chanmeletio/Astro_Avionics/hardware/rev_a/Avionics_BOM.csv

Reference | Qty | Value | Footprint | Mfg Part# | JLCPCB Part #
BZ1 | 1 | Buzzer | Buzzer_Beeper:Buzzer_Murata_PKMCS0909E | PKMCS0909E4000-R1 | C910763
C1,C6,C7,C8,C9,C12,C13,C14,C16,C17,C18,C21,C23,C24,C29,C39,C40,C41,C42,C43,C44 | 21 | 100nF | Capacitor_SMD:C_0603_1608Metric | CL10B104KB8NNNC | C1591
C2,C5 | 2 | 6.8pF | Capacitor_SMD:C_0603_1608Metric | CL10C6R8CB8NNNC | C318672
C3,C4 | 2 | 12pF | Capacitor_SMD:C_0603_1608Metric | CL10C120JB8NNNC | C38523
C10,C19,C20,C26,C32,C35,C36,C37 | 8 | 10uF | Capacitor_SMD:C_0603_1608Metric | CL10A106MA8NRNC | C96446
C11 | 1 | 100pF | Capacitor_SMD:C_0603_1608Metric | CL10C101JB8NNNC | C14858
C15,C22 | 2 | 4.7uF | Capacitor_SMD:C_0603_1608Metric | CL10A475KO8NNNC | C19666
C25,C27,C28,C38,C46 | 5 | 10nF | Capacitor_SMD:C_0603_1608Metric | CL10B103KB8NNNC | C1589
C30,C34 | 2 | C_470uF | Capacitor_SMD:C_Elec_10x10.2 | RVT1V471M1010 | C3350
C31,C33 | 2 | 22uF | Capacitor_SMD:C_0603_1608Metric | CL10A226MP8NUNE | C86295
C45,C47 | 2 | 2.2uF | Capacitor_SMD:C_0603_1608Metric | CL10B225KP8NNNC | C100082
C48 | 1 | 1uF | Capacitor_SMD:C_0603_1608Metric | CL10B105KB8NQNC | C5199872
D1 | 1 | 1N4148W | PCM_Diode_SMD_AKL:D_SOD-123 | 1N4148W | C81598
D2,D3,D4,D5,D8 | 5 | B240A | PCM_Diode_SMD_AKL:D_SMA | B240A | C39358
D6 | 1 | SMAJ9.0A | Diode_SMD:D_SMA | SMAJ9.0A | C113955
D7 | 1 | SMAJ5.0A | Diode_SMD:D_SMA | SMAJ5.0A/TR13 | C78401
D9 | 1 | SMAJ3.3A | Diode_SMD:D_SMA | SMAJ3.3A | C2917853
J1 | 1 | PINHD_1x4_Female | Connector_PinSocket_2.54mm:PinSocket_1x04_P2.54mm_Vertical | 22850104ANG1SYA01 | C41431927
J2 | 1 | U.FL | PCM_SparkFun-Connector:U.FL | BWU.FL-IPEX1 | C5137195
J3 | 1 | 472192001 | Kicad Doc:CONN_47219-2001_MOL | 472192001 | C164170
J4,J5,J6,J7,J8 | 5 | 436500503 | CONN_SD-43650-002_05_MOL | 436500503 | C19793673
L1 | 1 | 27nH @2GHz | Inductor_SMD:L_0603_1608Metric | SDCL0603Q27NJT02B02 | C279522
L2 | 1 | 10uH | Inductor_SMD:L_0805_2012Metric | MLF2012E100JT000 | C76742
L3 | 1 | 1k Ohm @ 100mHz | PCM_Ferrite_SMD_AKL:Ferrite_0603_1608Metric | BLM18KG102SH1D | C883597
LED1 | 1 | LED_0603_Blue | PCM_LED_SMD_AKL:LED_0603_1608Metric | KT-0603B | C2288
LED2 | 1 | LED_0603_Red | PCM_LED_SMD_AKL:LED_0603_1608Metric | KT-0603R | C2286
LED3 | 1 | LED_0603_Amber | PCM_LED_SMD_AKL:LED_0603_1608Metric | KT-0603Y | C2287
LED4 | 1 | LED_0603_Green | PCM_LED_SMD_AKL:LED_0603_1608Metric | KT-0603G | C12624
Q1 | 1 | IRLML2502 | PCM_Package_TO_SOT_SMD_AKL:SOT-23 | IRLML2502TRPBF-ES | C21713837
Q2,Q3,Q4,Q5 | 4 | IRLML6344 | PCM_Package_TO_SOT_SMD_AKL:SOT-23 | IRLML6344TRPBF-HXY | C6285738
Q6 | 1 | DMP3099L | PCM_Package_TO_SOT_SMD_AKL:SOT-23 | DMP3099L | C2940610
R1,R6,R31 | 3 | 1k | Resistor_SMD:R_0603_1608Metric | RC0603JR-071KL | C14676
R2,R3,R4,R7,R10,R13,R18,R20,R22,R24,R32 | 11 | 10k | Resistor_SMD:R_0603_1608Metric | RC0603JR-0710KL | C99198
R5,R17,R19,R21,R23 | 5 | 100 | Resistor_SMD:R_0603_1608Metric | RC0603FR-07100RL | C105588
R8,R15 | 2 | 100k | Resistor_SMD:R_0603_1608Metric | RC0603FR-07100KL | C14675
R9 | 1 | 47k | Resistor_SMD:R_0603_1608Metric | AC0603FR-0747KL | C111134
R11,R12 | 2 | 5.1k | Resistor_SMD:R_0603_1608Metric | RC0603FR-075K1L | C105580
R14 | 1 | 370k | Resistor_SMD:R_1206_3216Metric | SCR1206J370K | C3018094
R16 | 1 | 12.5k | Resistor_SMD:R_0603_1608Metric | MF1/8W ±1% 12K5 OTB5 | C337058
R25 | 1 | 82k | Resistor_SMD:R_0603_1608Metric | RC0603FR-0782KL | C137678
R26,R28 | 2 | 24k | Resistor_SMD:R_0603_1608Metric | AF0603FR-0724KL | C144095
R27 | 1 | 4.7k | Resistor_SMD:R_0603_1608Metric | RC0603FR-074K7L | C99782
R29 | 1 | 2.2k | Resistor_SMD:R_0603_1608Metric | RC0603FR-072K2L | C114662
R30 | 1 | 45.3k | Resistor_SMD:R_0603_1608Metric | AC0603FR-0745K3L | C227910
RN1 | 1 | R_10k_4x1206 | PCM_Resistor_SMD_AKL:R_Array_Concave_4x0603 | YC164-FR-0710KL | C110924
SW1,SW2 | 2 |  | Button_Switch_SMD:SW_Push_1P1T_NO_E-Switch_TL3301NxxxxxG | 4-1437565-1 | C592734
U1 | 1 | STM32F405RGT7TR | Kicad Doc:LQFP64-10x10mm | STM32F405RGT7TR | C2054405
U2 | 1 | H3LIS331DLTR | Kicad Doc:QFN_31DLTR_STM | H3LIS331DLTR | C2655074
U3 | 1 | MS560702BA03-50 | Kicad Doc:SON8_MS5611_TEC | MS560702BA03-50 | C97627
U4 | 1 | BMI270 | Kicad Doc:BMI270_BOS | BMI270 | C2836813
U5 | 1 | MAX-M10S-00B | Kicad Doc:XCVR_MAX-M10S-00B | MAX-M10S-00B | C4153167
U6 | 1 | E22-400M30S | Kicad Doc:E22-400M30S | E22-400M30S | C411292
U7 | 1 | TPD4E001DBVR | DBV6 | TPD4E001DBVR | C465736
U8 | 1 | 2137160001 | Kicad Doc:2137160001_MOL | 213716-0001 | C5119949
U9 | 1 | TPS259830ONRGER | Kicad Doc:IC_TPS259830LNRGER | TPS259830ONRGER | C20611808
U10 | 1 | TPS2121RUXR | RUX0012A | TPS2121RUXR | C485916
U11 | 1 | LMR51420XDDCR | SOT23_DDC_TEX | LMR51420XDDCR | C5246146
X1 | 1 | ABLS-8.000MHZ-B2-T | Kicad Doc:ABLS-8.000MHZ-B2-T_ABR | ABLS-8.000MHZ-B2-T | C596837
X2 | 1 | ABS07-32.768KHZ-T | Kicad Doc:CAP_ABS07-32.768KHZ-T_ABR | ABS07-32.768KHZ-T | C130253
