chanmeletio/Astro_Avionics/(list of files, cad)

Other CAD files:
hardware/rev_a/Avionics.step
