chanmeletio/Astro_Avionics/hardware/rev_a/New_Flight_Controller.kicad_pcb

## KiCad design hardware/rev_a/New_Flight_Controller.kicad_pcb (2026-10-27)

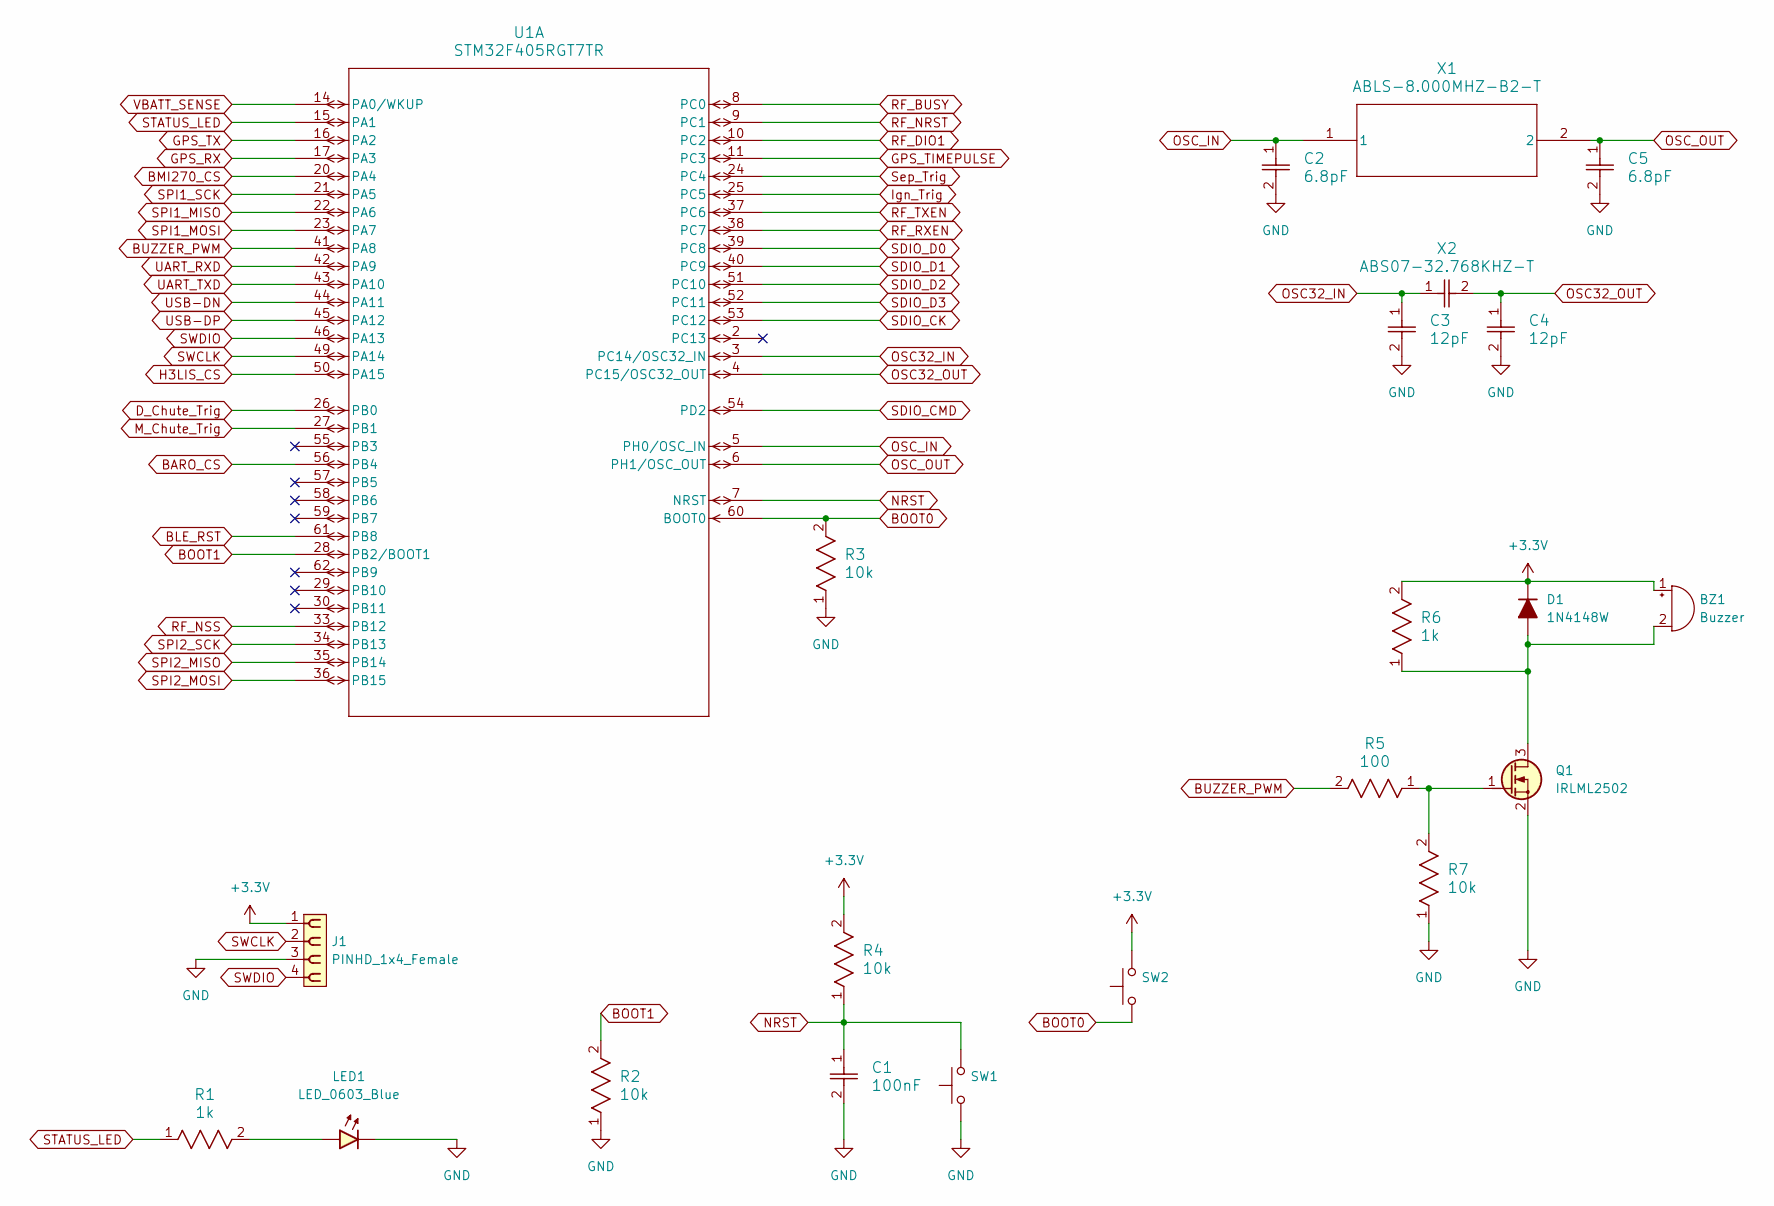
[picture p1: schematic mcu_1.kicad_sch, IREC 2027 SRAD Avionics]

Parts:
BZ1: Buzzer; Buzzer_Murata_PKMCS0909E; Mfg Part# PKMCS0909E4000-R1; JLCPCB Part # C910763
C1: 100nF; C_0603_1608Metric; Mfg Part# CL10B104KB8NNNC; JLCPCB Part # C1591
C2, C5: 6.8pF; C_0603_1608Metric; Mfg Part# CL10C6R8CB8NNNC; JLCPCB Part # C318672
C3, C4: 12pF; C_0603_1608Metric; Mfg Part# CL10C120JB8NNNC; JLCPCB Part # C38523
D1: 1N4148W; D_SOD-123; Mfg Part# 1N4148W; JLCPCB Part # C81598
J1: PINHD_1x4_Female; PinSocket_1x04_P2.54mm_Vertical; Mfg Part# 22850104ANG1SYA01; JLCPCB Part # C41431927
LED1: LED_0603_Blue; LED_0603_1608Metric; Mfg Part# KT-0603B; JLCPCB Part # C2288
Q1: IRLML2502; SOT-23; Mfg Part# IRLML2502TRPBF-ES; JLCPCB Part # C21713837
R1, R6: 1k; R_0603_1608Metric; Mfg Part# RC0603JR-071KL; JLCPCB Part # C14676
R2, R3, R4, R7: 10k; R_0603_1608Metric; Mfg Part# RC0603JR-0710KL; JLCPCB Part # C99198
R5: 100; R_0603_1608Metric; Mfg Part# RC0603FR-07100RL; JLCPCB Part # C105588
SW1, SW2: SW_Push_1P1T_NO_E-Switch_TL3301NxxxxxG; Mfg Part# 4-1437565-1; JLCPCB Part # C592734
U1: STM32F405RGT7TR; LQFP64-10x10mm; Mfg Part# STM32F405RGT7TR; JLCPCB Part # C2054405
X1: ABLS-8.000MHZ-B2-T; ABLS-8.000MHZ-B2-T_ABR; Mfg Part# ABLS-8.000MHZ-B2-T; JLCPCB Part # C596837
X2: ABS07-32.768KHZ-T; CAP_ABS07-32.768KHZ-T_ABR; Mfg Part# ABS07-32.768KHZ-T; JLCPCB Part # C130253

Connections:
+3.3V: BZ1.1 (+), D1.1 (K), J1.1, R4.2, R6.2, SW2.2; also elsewhere on the board
BARO_CS: U1.56 (PB4); also elsewhere on the board
BLE_RST: U1.61 (PB8); also elsewhere on the board
BMI270_CS: U1.20 (PA4); also elsewhere on the board
BOOT0: R3.2, SW2.1, U1.60 (BOOT0)
BOOT1: R2.2, U1.28 (PB2/BOOT1)
BUZZER_PWM: R5.2, U1.41 (PA8)
D_Chute_Trig: U1.26 (PB0); also elsewhere on the board
GND: C1.2, C2.2, C3.2, C4.2, C5.2, J1.3, LED1.1 (K), Q1.2 (S), R2.1, R3.1, R7.1, SW1.1; also elsewhere on the board
GPS_RX: U1.17 (PA3); also elsewhere on the board
GPS_TIMEPULSE: U1.11 (PC3); also elsewhere on the board
GPS_TX: U1.16 (PA2); also elsewhere on the board
H3LIS_CS: U1.50 (PA15); also elsewhere on the board
Ign_Trig: U1.25 (PC5); also elsewhere on the board
M_Chute_Trig: U1.27 (PB1); also elsewhere on the board
NRST: C1.1, R4.1, SW1.2, U1.7 (NRST)
unnamed: BZ1.2 (-), D1.2 (A), Q1.3 (D), R6.1
unnamed: LED1.2 (A), R1.2
unnamed: Q1.1 (G), R5.1, R7.2
OSC32_IN: C3.1, U1.3 (PC14/OSC32_IN), X2.1
OSC32_OUT: C4.1, U1.4 (PC15/OSC32_OUT), X2.2
OSC_IN: C2.1, U1.5 (PH0/OSC_IN), X1.1
OSC_OUT: C5.1, U1.6 (PH1/OSC_OUT), X1.2
RF_BUSY: U1.8 (PC0); also elsewhere on the board
RF_DIO1: U1.10 (PC2); also elsewhere on the board
RF_NRST: U1.9 (PC1); also elsewhere on the board
RF_NSS: U1.33 (PB12); also elsewhere on the board
RF_RXEN: U1.38 (PC7); also elsewhere on the board
RF_TXEN: U1.37 (PC6); also elsewhere on the board
SDIO_CK: U1.53 (PC12); also elsewhere on the board
SDIO_CMD: U1.54 (PD2); also elsewhere on the board
SDIO_D0: U1.39 (PC8); also elsewhere on the board
SDIO_D1: U1.40 (PC9); also elsewhere on the board
SDIO_D2: U1.51 (PC10); also elsewhere on the board
SDIO_D3: U1.52 (PC11); also elsewhere on the board
SPI1_MISO: U1.22 (PA6); also elsewhere on the board
SPI1_MOSI: U1.23 (PA7); also elsewhere on the board
SPI1_SCK: U1.21 (PA5); also elsewhere on the board
SPI2_MISO: U1.35 (PB14); also elsewhere on the board
SPI2_MOSI: U1.36 (PB15); also elsewhere on the board
SPI2_SCK: U1.34 (PB13); also elsewhere on the board
STATUS_LED: R1.1, U1.15 (PA1)
SWCLK: J1.2, U1.49 (PA14)
SWDIO: J1.4, U1.46 (PA13)
Sep_Trig: U1.24 (PC4); also elsewhere on the board
UART_RXD: U1.42 (PA9); also elsewhere on the board
UART_TXD: U1.43 (PA10); also elsewhere on the board
USB-DN: U1.44 (PA11); also elsewhere on the board
USB-DP: U1.45 (PA12); also elsewhere on the board
VBATT_SENSE: U1.14 (PA0/WKUP); also elsewhere on the board

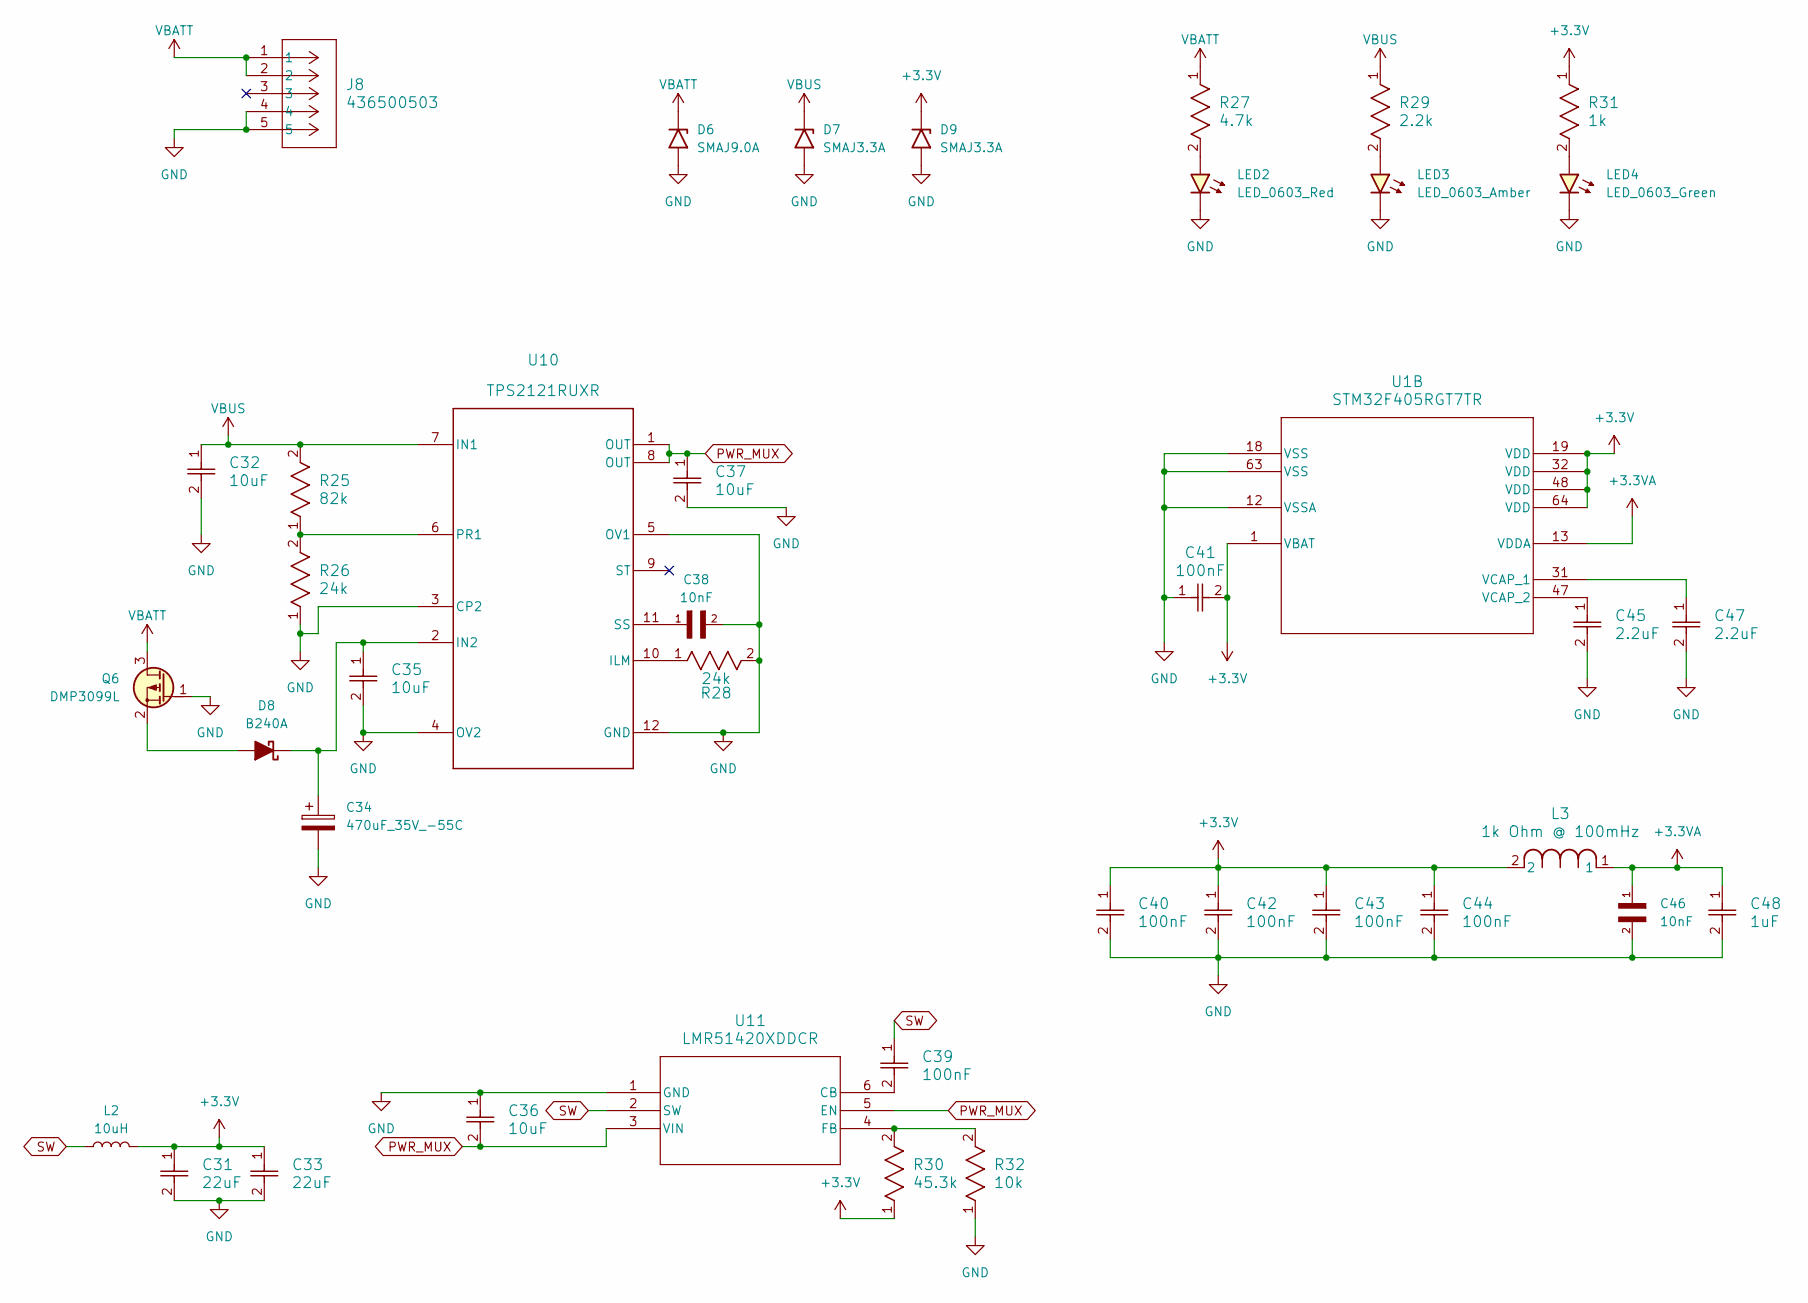
[picture p2: schematic power.kicad_sch, IREC 2027 SRAD Avionics]

Parts:
C31, C33: 22uF; C_0603_1608Metric; Mfg Part# CL10A226MP8NUNE; JLCPCB Part # C86295
C32, C35, C36, C37: 10uF; C_0603_1608Metric; Mfg Part# CL10A106MA8NRNC; JLCPCB Part # C96446
C34: 470uF_35V_-55C; C_Elec_10x10.2; Mfg Part# 189RV0073; JLCPCB Part # C18203153
C38, C46: 10nF; C_0603_1608Metric; Mfg Part# CL10B103KB8NNNC; JLCPCB Part # C1589
C39, C40, C41, C42, C43, C44: 100nF; C_0603_1608Metric; Mfg Part# CL10B104KB8NNNC; JLCPCB Part # C1591
C45, C47: 2.2uF; C_0603_1608Metric; Mfg Part# CL10B225KP8NNNC; JLCPCB Part # C100082
C48: 1uF; C_0603_1608Metric; Mfg Part# CL10B105KB8NQNC; JLCPCB Part # C5199872
D6: SMAJ9.0A; D_SMA; Mfg Part# SMAJ9.0A; JLCPCB Part # C113955
D7: SMAJ3.3A; D_SMA; Mfg Part# SMAJ3.3A; JLCPCB Part # C18199544
D8: B240A; D_SMA; Mfg Part# B240A; JLCPCB Part # C39358
D9: SMAJ3.3A; D_SMA; Mfg Part# SMAJ3.3A; JLCPCB Part # C2917853
J8: 436500503; CONN_SD-43650-002_05_MOL; Mfg Part# 436500503; JLCPCB Part # C19793673
L2: 10uH; L_0805_2012Metric; Mfg Part# MLF2012E100JT000; JLCPCB Part # C76742
L3: 1k Ohm @ 100mHz; Ferrite_0603_1608Metric; Mfg Part# BLM18KG102SH1D; JLCPCB Part # C883597
LED2: LED_0603_Red; LED_0603_1608Metric; Mfg Part# KT-0603R; JLCPCB Part # C2286
LED3: LED_0603_Amber; LED_0603_1608Metric; Mfg Part# KT-0603Y; JLCPCB Part # C2287
LED4: LED_0603_Green; LED_0603_1608Metric; Mfg Part# KT-0603G; JLCPCB Part # C12624
Q6: DMP3099L; SOT-23; Mfg Part# DMP3099L; JLCPCB Part # C2940610
R25: 82k; R_0603_1608Metric; Mfg Part# RC0603FR-0782KL; JLCPCB Part # C137678
R26, R28: 24k; R_0603_1608Metric; Mfg Part# 0603WAF2402T5E; JLCPCB Part # C23352
R27: 4.7k; R_0603_1608Metric; Mfg Part# RC0603FR-074K7L; JLCPCB Part # C99782
R29: 2.2k; R_0603_1608Metric; Mfg Part# RC0603FR-072K2L; JLCPCB Part # C114662
R30: 45.3k; R_0603_1608Metric; Mfg Part# AC0603FR-0745K3L; JLCPCB Part # C227910
R31: 1k; R_0603_1608Metric; Mfg Part# RC0603JR-071KL; JLCPCB Part # C14676
R32: 10k; R_0603_1608Metric; Mfg Part# RC0603JR-0710KL; JLCPCB Part # C99198
U1: STM32F405RGT7TR; LQFP64-10x10mm; Mfg Part# STM32F405RGT7TR; JLCPCB Part # C2054405
U10: TPS2121RUXR; RUX0012A; Mfg Part# TPS2121RUXR; JLCPCB Part # C485916
U11: LMR51420XDDCR; SOT23_DDC_TEX; Mfg Part# LMR51420XDDCR; JLCPCB Part # C5246146

Connections:
+3.3V: C31.1, C33.1, C40.1, C41.2, C42.1, C43.1, C44.1, D9.1 (A1), L2.2, L3.2, R30.1, R31.1, U1.1 (VBAT), U1.19 (VDD), U1.32 (VDD), U1.48 (VDD), U1.64 (VDD); also elsewhere on the board
+3.3VA: C46.1, C48.1, L3.1, U1.13 (VDDA)
GND: C31.2, C32.2, C33.2, C34.2, C35.2, C36.1, C37.2, C38.2, C40.2, C41.1, C42.2, C43.2, C44.2, C45.2, C46.2, C47.2, C48.2, D6.2 (A2), D7.2 (A2), D9.2 (A2), J8.4, J8.5, LED2.1 (K), LED3.1 (K), LED4.1 (K), Q6.1 (G), R26.1, R28.2, R32.1, U1.12 (VSSA), U1.18 (VSS), U1.63 (VSS), U10.3 (CP2), U10.4 (OV2), U10.5 (OV1), U10.12 (GND), U11.1 (GND); also elsewhere on the board
unnamed: D8.2 (A), Q6.2 (S)
unnamed: C34.1, C35.1, D8.1 (K), U10.2 (IN2)
unnamed: LED2.2 (A), R27.2
unnamed: LED3.2 (A), R29.2
unnamed: LED4.2 (A), R31.2
unnamed: C47.1, U1.31 (VCAP_1)
unnamed: C45.1, U1.47 (VCAP_2)
unnamed: R28.1, U10.10 (ILM)
unnamed: R25.1, R26.2, U10.6 (PR1)
unnamed: C38.1, U10.11 (SS)
unnamed: C39.2, U11.6 (CB)
unnamed: R30.2, R32.2, U11.4 (FB)
PWR_MUX: C36.2, C37.1, U10.1 (OUT), U10.8 (OUT), U11.3 (VIN), U11.5 (EN)
SW: C39.1, L2.1, U11.2 (SW)
VBATT: D6.1 (A1), J8.1, J8.2, Q6.3 (D), R27.1; also elsewhere on the board
VBUS: C32.1, D7.1 (A1), R25.2, R29.1, U10.7 (IN1); also elsewhere on the board

Schematic: microsd.kicad_sch, IREC 2027 SRAD Avionics

Parts:
C21, C23: 100nF; C_0603_1608Metric; Mfg Part# CL10B104KB8NNNC; JLCPCB Part # C1591
C22: 4.7uF; C_0603_1608Metric; Mfg Part# CL10A475KO8NNNC; JLCPCB Part # C19666
J3: 472192001; CONN_47219-2001_MOL; Mfg Part# 472192001; JLCPCB Part # C164170
R11, R12: 5.1k; R_0603_1608Metric; Mfg Part# RC0603FR-075K1L; JLCPCB Part # C105580
R13: 10k; R_0603_1608Metric; Mfg Part# RC0603JR-0710KL; JLCPCB Part # C99198
RN1: R_10k_4x1206; R_Array_Concave_4x0603; Mfg Part# YC164-FR-0710KL; JLCPCB Part # C110924
U7: TPD4E001DBVR; SOT-23-6; Mfg Part# TPD4E001DBVR; JLCPCB Part # C465736
U8: 2137160001; 2137160001_MOL; Mfg Part# 213716-0001; JLCPCB Part # C5119949

Connections:
+3.3V: C22.1, C23.1, J3.4, R13.1, RN1.1 (R1.1), RN1.2 (R2.1), RN1.3 (R3.1), RN1.4 (R4.1); also elsewhere on the board
CC1: R11.1, U7.3 (IO2), U8.A5 (CC1)
CC2: R12.2, U7.4 (IO3), U8.B5 (CC2)
GND: C21.2, C22.2, C23.2, J3.6, R11.2, R12.1, U7.2 (GND), U8.A1 (GND), U8.A12 (GND), U8.B1 (GND), U8.B12 (GND); also elsewhere on the board
SDIO_CK: J3.5; also elsewhere on the board
SDIO_CMD: J3.3, RN1.6 (R3.2); also elsewhere on the board
SDIO_D0: J3.7, R13.2; also elsewhere on the board
SDIO_D1: J3.8, RN1.5 (R4.2); also elsewhere on the board
SDIO_D2: J3.1, RN1.8 (R1.2); also elsewhere on the board
SDIO_D3: J3.2, RN1.7 (R2.2); also elsewhere on the board
USB-DN: U7.6 (IO4), U8.A7 (DN1), U8.B7 (DN2); also elsewhere on the board
USB-DP: U7.1 (IO1), U8.A6 (DP1), U8.B6 (DP2); also elsewhere on the board
VBUS: C21.1, U7.5 (VCC), U8.A4 (VBUS), U8.A9 (VBUS), U8.B4 (VBUS), U8.B9 (VBUS); also elsewhere on the board

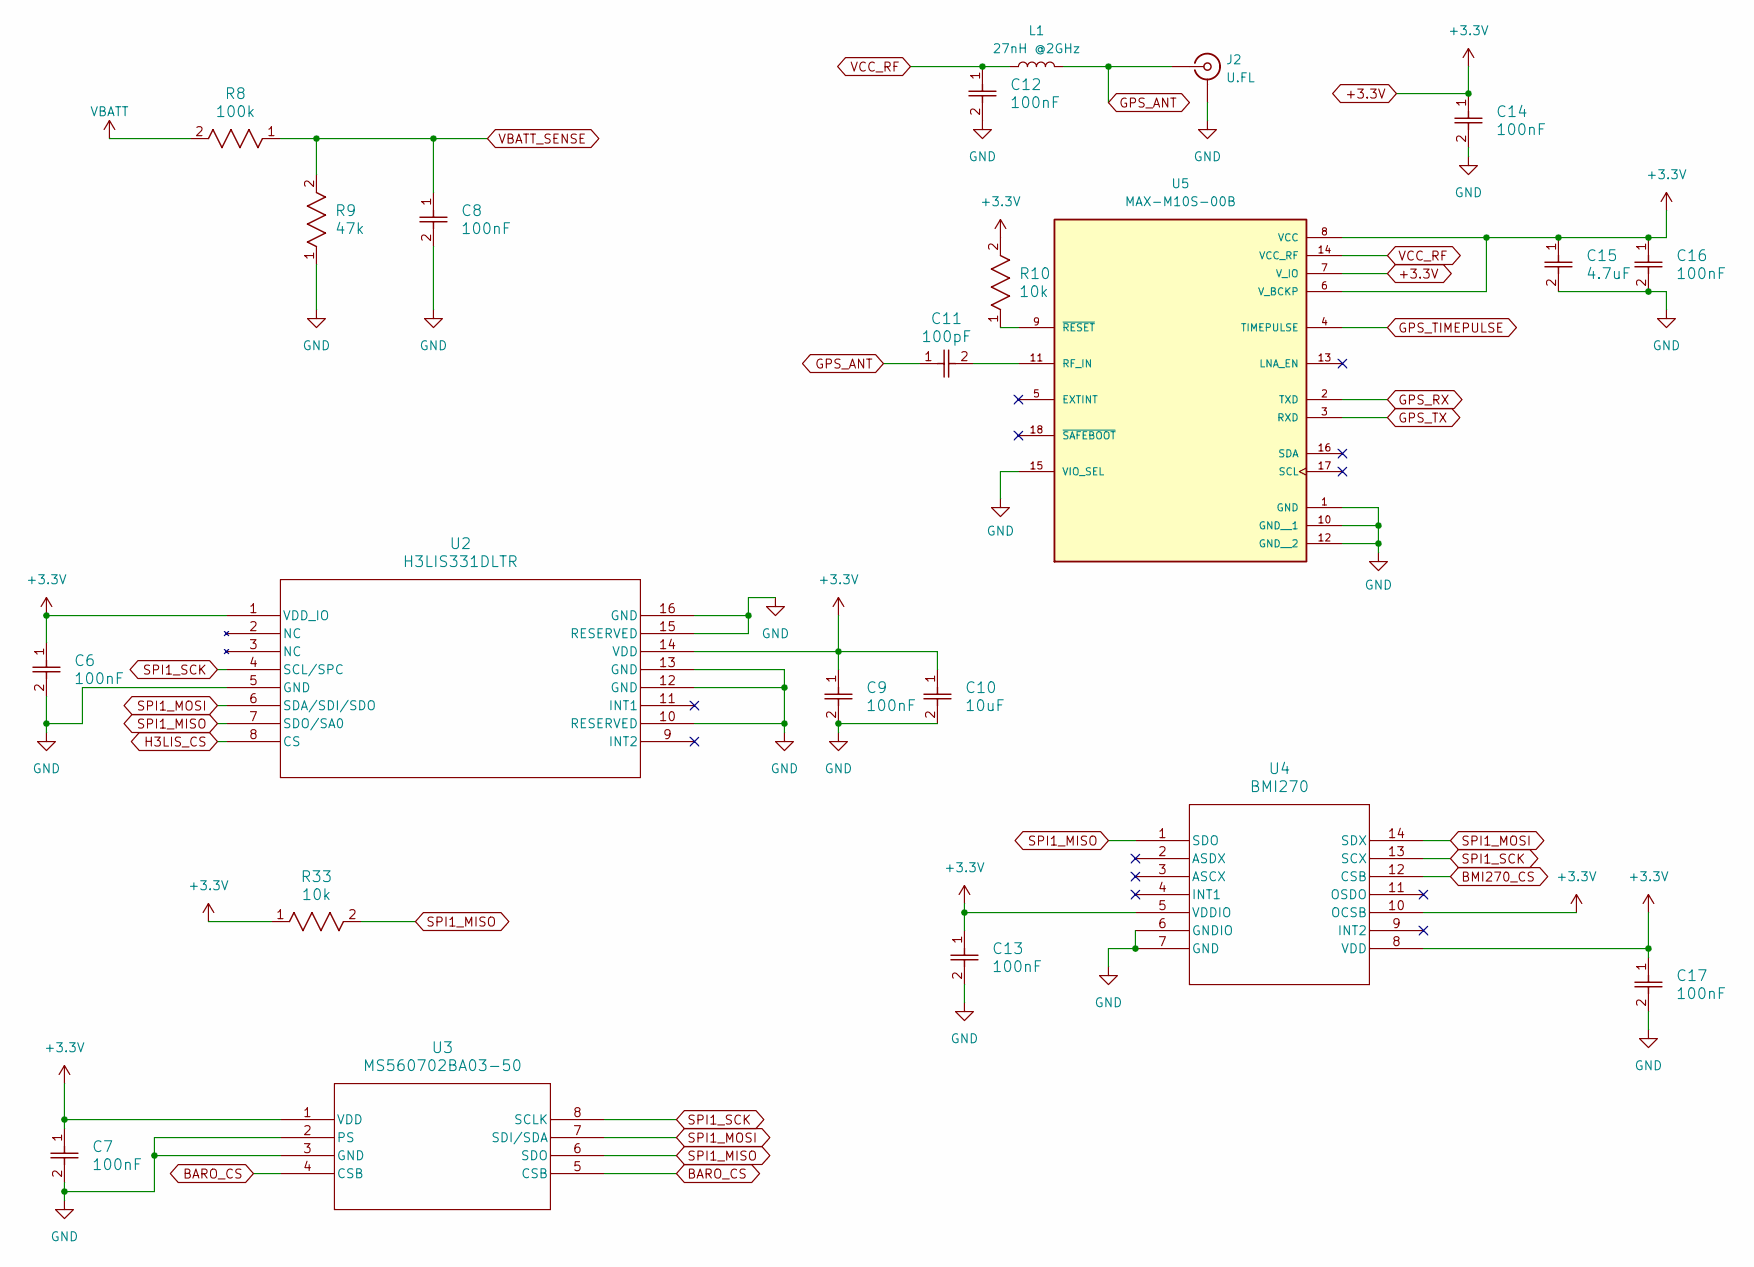
[picture p3: schematic sensors.kicad_sch, IREC 2027 SRAD Avionics]

Parts:
C6, C7, C8, C9, C12, C13, C14, C16, C17: 100nF; C_0603_1608Metric; Mfg Part# CL10B104KB8NNNC; JLCPCB Part # C1591
C10: 10uF; C_0603_1608Metric; Mfg Part# CL10A106MA8NRNC; JLCPCB Part # C96446
C11: 100pF; C_0603_1608Metric; Mfg Part# CL10C101JB8NNNC; JLCPCB Part # C14858
C15: 4.7uF; C_0603_1608Metric; Mfg Part# CL10A475KO8NNNC; JLCPCB Part # C19666
J2: U.FL; Mfg Part# BWU.FL-IPEX1; JLCPCB Part # C5137195
L1: 27nH @2GHz; L_0603_1608Metric; Mfg Part# SDCL0603Q27NJT02B02; JLCPCB Part # C279522
R8: 100k; R_0603_1608Metric; Mfg Part# RC0603FR-07100KL; JLCPCB Part # C14675
R9: 47k; R_0603_1608Metric; Mfg Part# AC0603FR-0747KL; JLCPCB Part # C111134
R10, R33: 10k; R_0603_1608Metric; Mfg Part# RC0603JR-0710KL; JLCPCB Part # C99198
U2: H3LIS331DLTR; QFN_31DLTR_STM; Mfg Part# H3LIS331DLTR; JLCPCB Part # C2655074
U3: MS560702BA03-50; SON8_MS5611_TEC; Mfg Part# MS560702BA03-50; JLCPCB Part # C97627
U4: BMI270; BMI270_BOS; Mfg Part# BMI270; JLCPCB Part # C2836813
U5: MAX-M10S-00B; XCVR_MAX-M10S-00B; PARTREV C1; JLCPCB Part # C4153167

Connections:
+3.3V: C6.1, C7.1, C9.1, C10.1, C13.1, C14.1, C15.1, C16.1, C17.1, R10.2, R33.1, U2.1 (VDD_IO), U2.14 (VDD), U3.1 (VDD), U4.5 (VDDIO), U4.8 (VDD), U4.10 (OCSB), U5.6 (V_BCKP), U5.7 (V_IO), U5.8 (VCC); also elsewhere on the board
BARO_CS: U3.4 (CSB), U3.5 (CSB); also elsewhere on the board
BMI270_CS: U4.12 (CSB); also elsewhere on the board
GND: C6.2, C7.2, C8.2, C9.2, C10.2, C12.2, C13.2, C14.2, C15.2, C16.2, C17.2, J2.2 (Ext), R9.1, U2.5 (GND), U2.10 (RESERVED), U2.12 (GND), U2.13 (GND), U2.15 (RESERVED), U2.16 (GND), U3.2 (PS), U3.3 (GND), U4.6 (GNDIO), U4.7 (GND), U5.1 (GND), U5.10 (GND__1), U5.12 (GND__2), U5.15 (VIO_SEL); also elsewhere on the board
GPS_ANT: C11.1, J2.1 (In), L1.2
GPS_RX: U5.2 (TXD); also elsewhere on the board
GPS_TIMEPULSE: U5.4 (TIMEPULSE); also elsewhere on the board
GPS_TX: U5.3 (RXD); also elsewhere on the board
H3LIS_CS: U2.8 (CS); also elsewhere on the board
unnamed: C11.2, U5.11 (RF_IN)
unnamed: R10.1, U5.9 (~RESET)
SPI1_MISO: R33.2, U2.7 (SDO/SA0), U3.6 (SDO), U4.1 (SDO); also elsewhere on the board
SPI1_MOSI: U2.6 (SDA/SDI/SDO), U3.7 (SDI/SDA), U4.14 (SDX); also elsewhere on the board
SPI1_SCK: U2.4 (SCL/SPC), U3.8 (SCLK), U4.13 (SCX); also elsewhere on the board
VBATT: R8.2; also elsewhere on the board
VBATT_SENSE: C8.1, R8.1, R9.2; also elsewhere on the board
VCC_RF: C12.1, L1.1, U5.14 (VCC_RF)

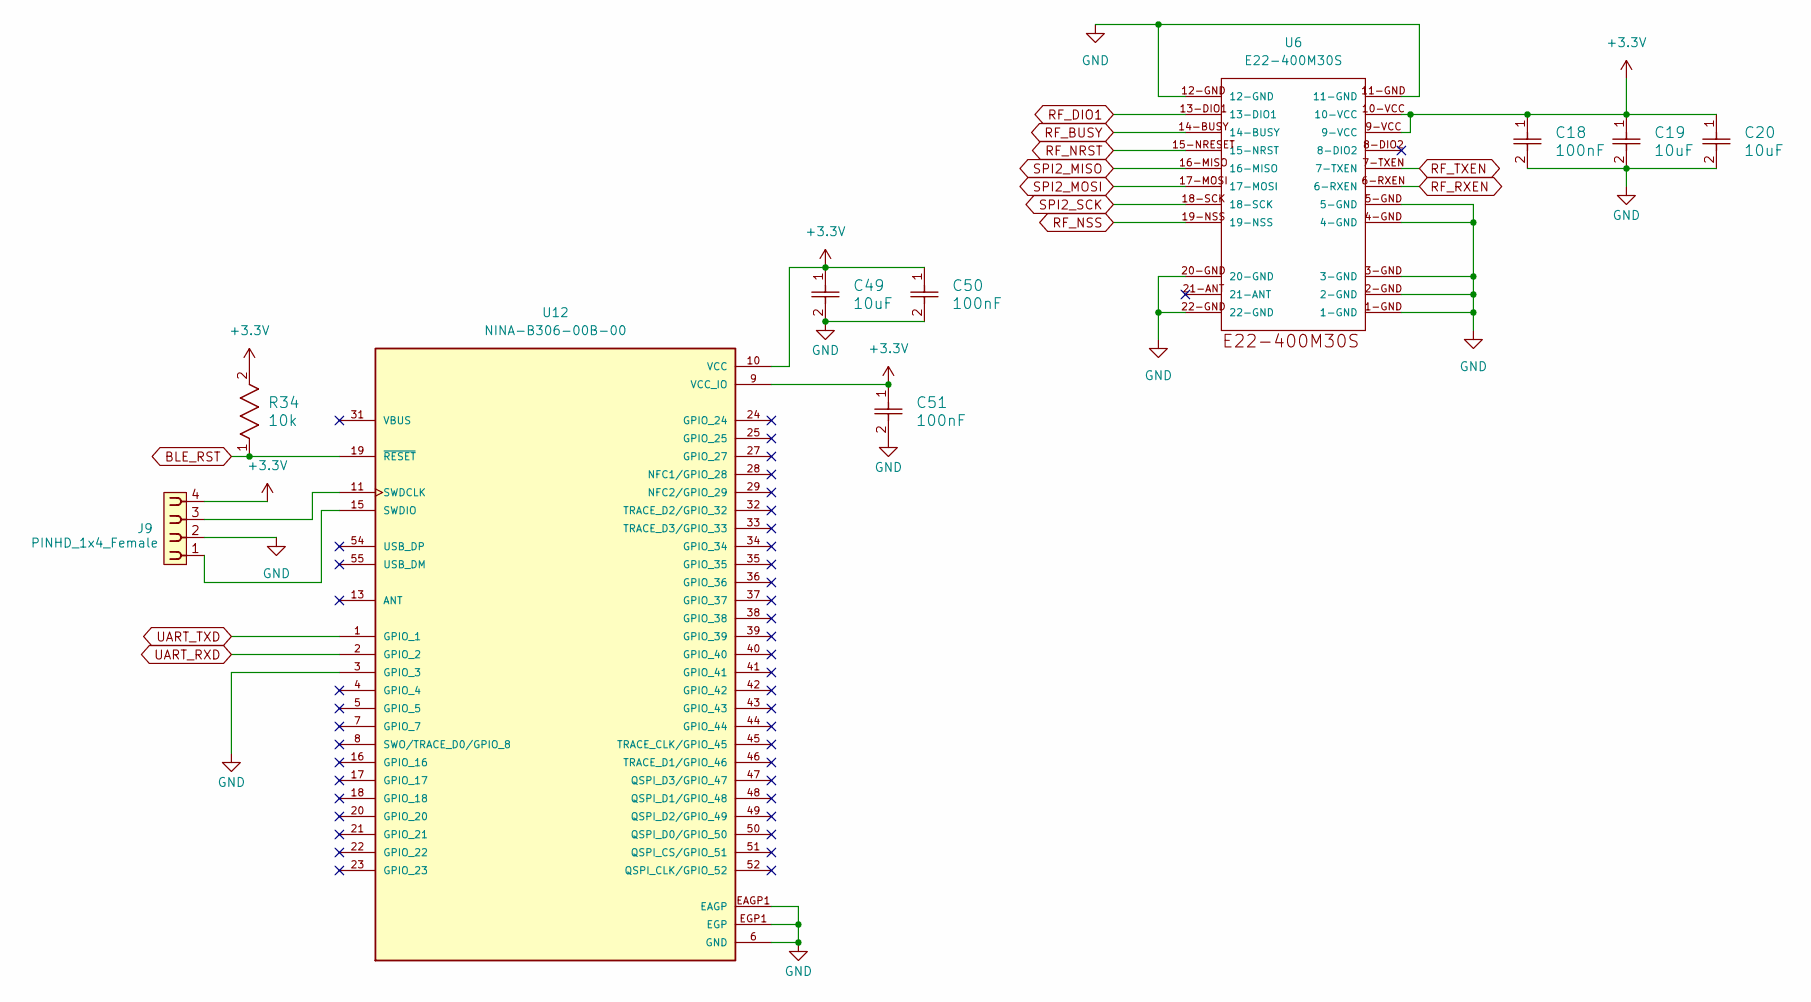
[picture p4: schematic radio.kicad_sch, IREC 2027 SRAD Avionics]

Parts:
C18, C50, C51: 100nF; C_0603_1608Metric; Mfg Part# CL10B104KB8NNNC; JLCPCB Part # C1591
C19, C20, C49: 10uF; C_0603_1608Metric; Mfg Part# CL10A106MA8NRNC; JLCPCB Part # C96446
J9: PINHD_1x4_Female; PinSocket_1x04_P2.54mm_Vertical; Mfg Part# 22850104ANG1SYA01; JLCPCB Part # C41431927
R34: 10k; R_0603_1608Metric; Mfg Part# RC0603JR-0710KL; JLCPCB Part # C99198
U6: E22-400M30S; Mfg Part# E22-400M30S; JLCPCB Part # C411292
U12: NINA-B306-00B-00; XCVR_NINA-B306-00B-00; PARTREV R07

Connections:
+3.3V: C18.1, C19.1, C20.1, C49.1, C50.1, C51.1, J9.4, R34.2, U6.9-VCC, U6.10-VCC, U12.9 (VCC_IO), U12.10 (VCC); also elsewhere on the board
BLE_RST: R34.1, U12.19 (~RESET); also elsewhere on the board
GND: C18.2, C19.2, C20.2, C49.2, C50.2, C51.2, J9.2, U6.1-GND, U6.2-GND, U6.3-GND, U6.4-GND, U6.5-GND, U6.11-GND, U6.12-GND, U6.20-GND, U6.22-GND, U12.3 (GPIO_3), U12.6 (GND), U12.12 (GND), U12.14 (GND), U12.26 (GND), U12.30 (GND), U12.53 (GND), U12.EAGP1 (EAGP), U12.EAGP2 (EAGP), U12.EAGP3 (EAGP), U12.EAGP4 (EAGP), U12.EGP1 (EGP), U12.EGP2 (EGP), U12.EGP3 (EGP), U12.EGP4 (EGP), U12.EGP5 (EGP), U12.EGP6 (EGP), U12.EGP7 (EGP), U12.EGP8 (EGP), U12.EGP9 (EGP), U12.EGP10 (EGP), U12.EGP11 (EGP), U12.EGP12 (EGP); also elsewhere on the board
unnamed: J9.3, U12.11 (SWDCLK)
unnamed: J9.1, U12.15 (SWDIO)
RF_BUSY: U6.14-BUSY; also elsewhere on the board
RF_DIO1: U6.13-DIO1; also elsewhere on the board
RF_NRST: U6.15-NRESET (15-NRST); also elsewhere on the board
RF_NSS: U6.19-NSS; also elsewhere on the board
RF_RXEN: U6.6-RXEN; also elsewhere on the board
RF_TXEN: U6.7-TXEN; also elsewhere on the board
SPI2_MISO: U6.16-MISO; also elsewhere on the board
SPI2_MOSI: U6.17-MOSI; also elsewhere on the board
SPI2_SCK: U6.18-SCK; also elsewhere on the board
UART_RXD: U12.2 (GPIO_2); also elsewhere on the board
UART_TXD: U12.1 (GPIO_1); also elsewhere on the board

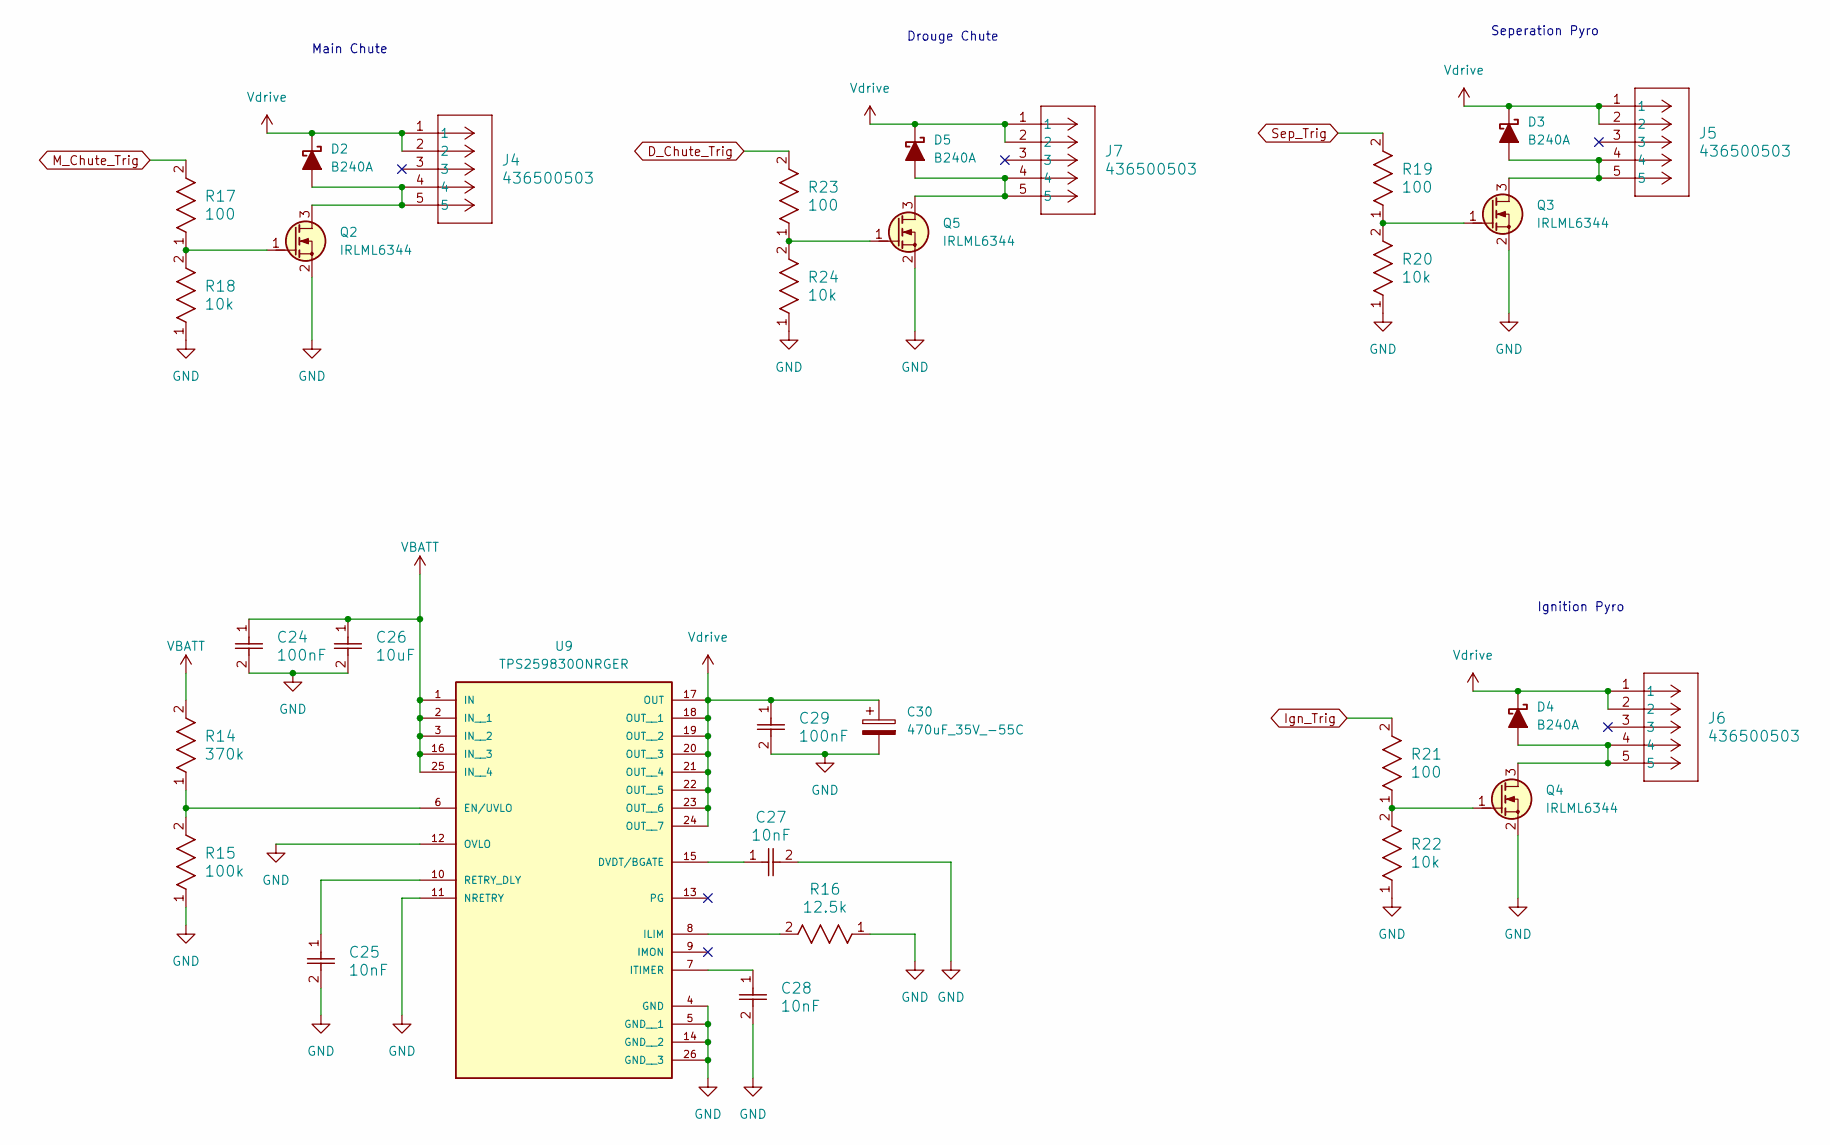
[picture p5: schematic pyro.kicad_sch, IREC 2027 SRAD Avionics]

Parts:
C24, C29: 100nF; C_0603_1608Metric; Mfg Part# CL10B104KB8NNNC; JLCPCB Part # C1591
C25, C27, C28: 10nF; C_0603_1608Metric; Mfg Part# CL10B103KB8NNNC; JLCPCB Part # C1589
C26: 10uF; C_0603_1608Metric; Mfg Part# CL10A106MA8NRNC; JLCPCB Part # C96446
C30: 470uF_35V_-55C; C_Elec_10x10.2; Mfg Part# 189RV0073; JLCPCB Part # C18203153
D2, D3, D4, D5: B240A; D_SMA; Mfg Part# B240A; JLCPCB Part # C39358
J4, J5, J6, J7: 436500503; CONN_SD-43650-002_05_MOL; Mfg Part# 436500503; JLCPCB Part # C19793673
Q2, Q3, Q4, Q5: IRLML6344; SOT-23; Mfg Part# IRLML6344TRPBF-HXY; JLCPCB Part # C6285738
R14: 370k; R_1206_3216Metric; Mfg Part# SCR1206J370K; JLCPCB Part # C3018094
R15: 100k; R_0603_1608Metric; Mfg Part# RC0603FR-07100KL; JLCPCB Part # C14675
R16: 12.5k; R_0603_1608Metric; Mfg Part# MF1/8W ±1% 12K5 OTB5; JLCPCB Part # C337058
R17, R19, R21, R23: 100; R_0603_1608Metric; Mfg Part# RC0603FR-07100RL; JLCPCB Part # C105588
R18, R20, R22, R24: 10k; R_0603_1608Metric; Mfg Part# RC0603JR-0710KL; JLCPCB Part # C99198
U9: TPS259830ONRGER; IC_TPS259830LNRGER; PARTREV B; JLCPCB Part # C20611808

Connections:
D_Chute_Trig: R23.2; also elsewhere on the board
GND: C24.2, C25.2, C26.2, C27.2, C28.2, C29.2, C30.2, Q2.2 (S), Q3.2 (S), Q4.2 (S), Q5.2 (S), R15.1, R16.1, R18.1, R20.1, R22.1, R24.1, U9.4 (GND), U9.5 (GND__1), U9.11 (NRETRY), U9.12 (OVLO), U9.14 (GND__2), U9.26 (GND__3); also elsewhere on the board
Ign_Trig: R21.2; also elsewhere on the board
M_Chute_Trig: R17.2; also elsewhere on the board
unnamed: D2.2 (A), J4.4, J4.5, Q2.3 (D)
unnamed: D3.2 (A), J5.4, J5.5, Q3.3 (D)
unnamed: D4.2 (A), J6.4, J6.5, Q4.3 (D)
unnamed: D5.2 (A), J7.4, J7.5, Q5.3 (D)
unnamed: Q2.1 (G), R17.1, R18.2
unnamed: Q3.1 (G), R19.1, R20.2
unnamed: Q4.1 (G), R21.1, R22.2
unnamed: Q5.1 (G), R23.1, R24.2
unnamed: C27.1, U9.15 (DVDT/BGATE)
unnamed: R14.1, R15.2, U9.6 (EN/UVLO)
unnamed: R16.2, U9.8 (ILIM)
unnamed: C28.1, U9.7 (ITIMER)
unnamed: C25.1, U9.10 (RETRY_DLY)
Sep_Trig: R19.2; also elsewhere on the board
VBATT: C24.1, C26.1, R14.2, U9.1 (IN), U9.2 (IN__1), U9.3 (IN__2), U9.16 (IN__3), U9.25 (IN__4); also elsewhere on the board
Vdrive: C29.1, C30.1, D2.1 (K), D3.1 (K), D4.1 (K), D5.1 (K), J4.1, J4.2, J5.1, J5.2, J6.1, J6.2, J7.1, J7.2, U9.17 (OUT), U9.18 (OUT__1), U9.19 (OUT__2), U9.20 (OUT__3), U9.21 (OUT__4), U9.22 (OUT__5), U9.23 (OUT__6), U9.24 (OUT__7)

Notes on the sheet:
Drouge Chute
Seperation Pyro
Main Chute
Ignition Pyro

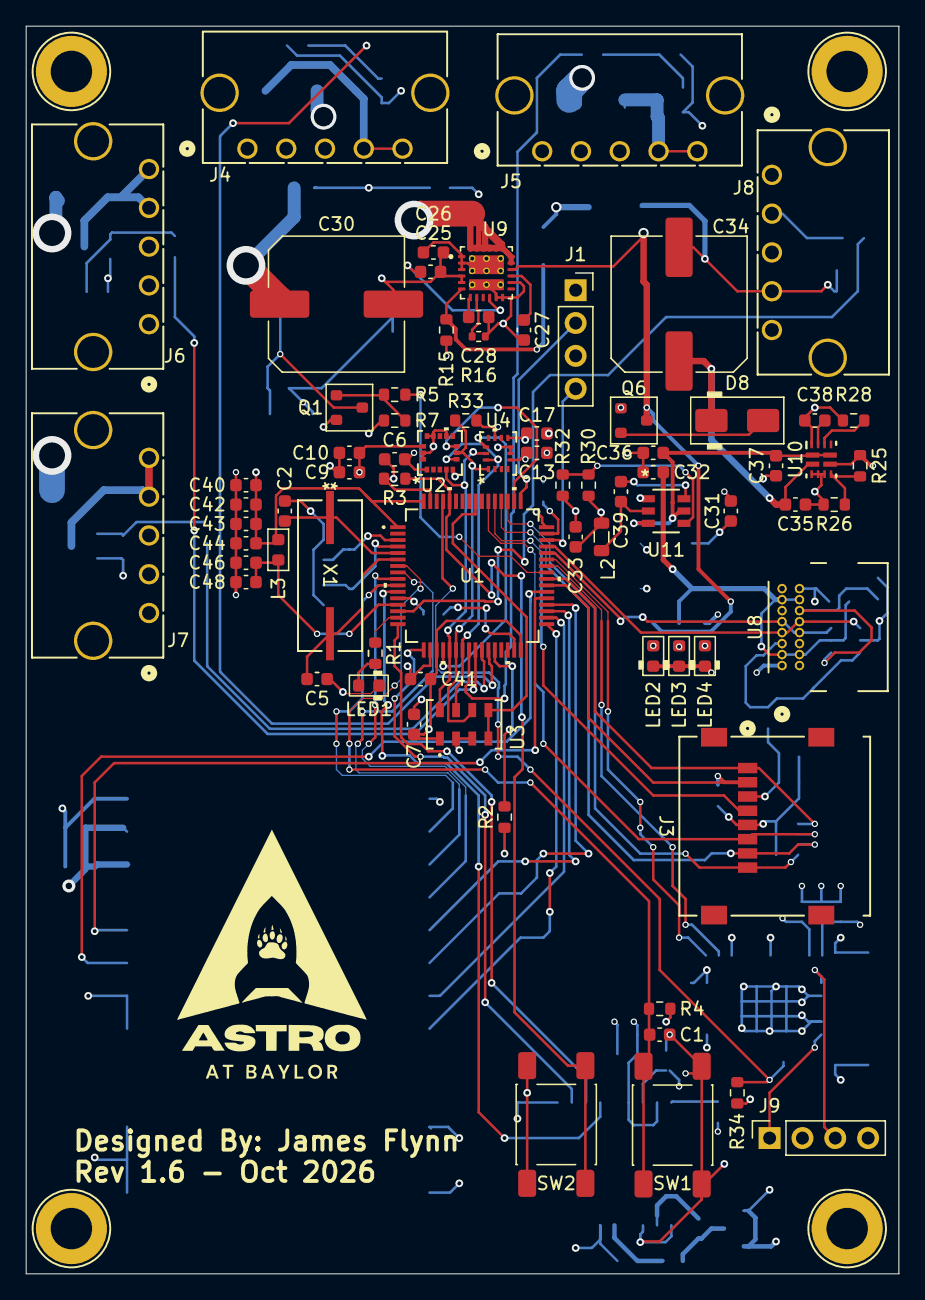
[picture p6: board New_Flight_Controller.kicad_pcb from above]

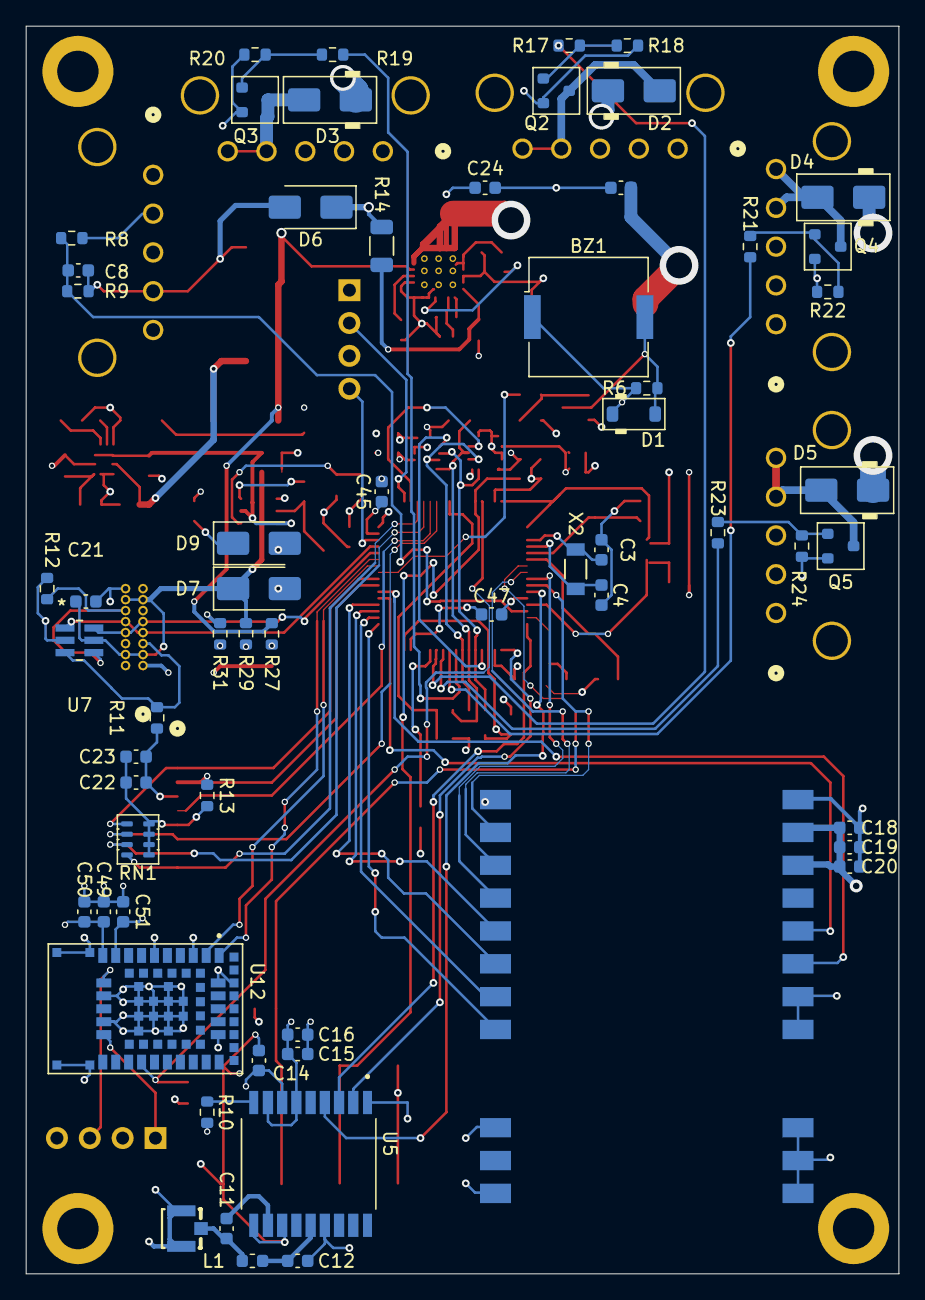
[picture p7: board New_Flight_Controller.kicad_pcb from below]

Board: 4 copper layers, 67.5 x 96.5 mm, 134 parts (61 on the bottom side), 89 nets.
