chanmeletio/Astro_Avionics/(commit log)

2026-10-27 Setup repository infrastructure, KiCad v10 CI/CD workflows, and MIT license
2026-10-27 bom and placement edit
    [New_Flight_Controller.kicad_pcb, V1.6_bom.csv, V1.6_positions.csv]
2026-10-27 placement edit
    [New_Flight_Controller.kicad_pcb, V1.6_positions.csv]
