chanmeletio/Astro_Avionics/(notices)

Notices in the files:
README.md:
License: MIT
